Babaganoush07/xiao_macropad/Case/macro_pad_V2.FCStd

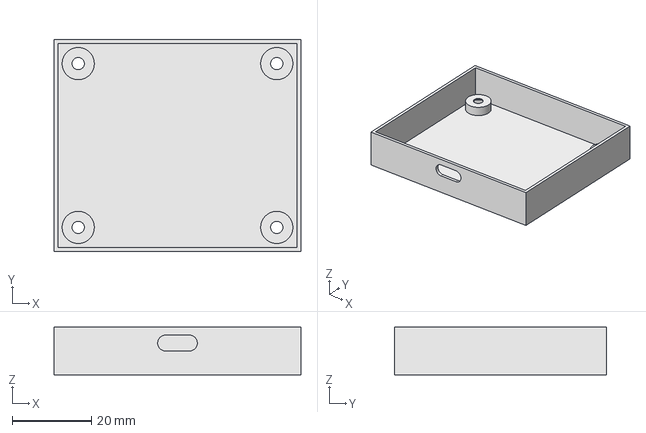
[picture p10: CAD file, 2023-11-20]
Case/macro_pad_V2.FCStd
62.2 x 53.5 x 12.0 mm
