Babaganoush07/xiao_macropad/(list of files, cad)

Other CAD files:
Case/macro_pad_V1.FCStd
Case/macro_pad_V1.stl
Case/macro_pad_V2.stl
