Babaganoush07/xiao_macropad/PCB/Schematic_xiao macropad.pdf

A | A

1

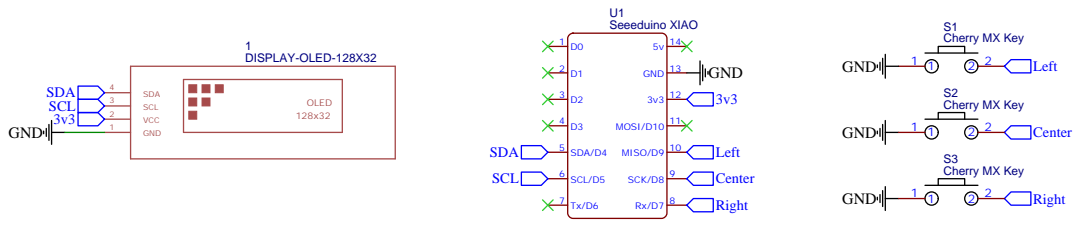
[picture p11: page 1]
