Babaganoush07/xiao_macropad/(commit log)

2023-02-16 Create prototypes
2023-11-19 Update README.md
    added case info
2023-11-19 Add files via upload
    CAD file
    [macro_pad.FCStd]
2023-11-19 STL file
    [macro_pad.stl]
2023-11-20 V1 stl, Xiao on top
    [macro_pad_V1.stl]
2023-11-20 V1 CAD, Xiao on top
    [macro_pad_V1.FCStd]
2023-11-20 V2 CAD, Xiao on bottom
    [macro_pad_V2.FCStd]
2023-11-20 V2 stl, Xiao on bottom
    [macro_pad_V2.stl]
